WCKDai/tinyrex/design/AUDIT.md

# TinyREX v4 — model audit

A part-by-part check of the Blender model:
- what each part is and what it is made of;
- whether it can be printed, fixed and assembled;
- whether everything clears everything else in motion;
- how it compares with Microduck.

The checks are scripts, re-run after every change:

| Check | Script | What it does |
|---|---|---|
| Inventory | `blender/audit.py` | Role, material, size, watertightness, thinnest wall, fixings |
| Clips | `rig.py` `clips` / `part_check` | Every joint swept through its range against every part |
| Floating parts | `rig.py` `supports` | Each part must reach its body's hardware through parts it touches |
| Screws | `v4_parts.py` `part_bosses` | Rays along each screw: thread or insert behind it, or a boss is added |
| Limits | `limits.py` bisection | Collision-free joint ranges |
| Balance | `blender/mass.py` | Mass and balance |
| Simulation | `sim/stand_test.py` | Standing in MuJoCo |

Labelled renders: `renders/labelled-{hero,back,exploded}-annotated.png`.

## Inventory

The model has **266 parts**:
- 18 Dynamixel XL330 servos, each named by the joint it drives in the labelled renders;
- 23 frame brackets and 14 bearings, in Microduck's layout;
- 13 electronics parts and 3 cables (the camera CSI flex and the two arm-servo leads);
- 64 printed parts in PETG: 9 shells and the rest solid-modelled. The spikes, brows, eye sockets, toe caps and every
  insert boss print with the part they sit on, so none is glued on any more;
- 11 TPU parts: soles, toe soles, the tail tip, and the friction parts of the four slip clutches;
- 6 steel pins (jaw shafts, cheek pins, elbow pins), 3 wave springs, the 4 mm carbon tail spine;
- 3 polycarbonate parts: the two eye domes and the visor window;
- 107 M2 screws:
  - 73 on the shells and plates;
  - 34 fixing the frame brackets into the XL330s' own case-screw holes.

The XL330s' own horn and case screws aren't counted; they come with the servos.

## Built to tumble

TinyREX falls over and gets itself up with its head, tail and arms, so it has to take knocks. Falls in the simulator
(60 walking falls, shoved hard) show the hits: the head and tail land first and fastest (about 1.7–1.8 m/s), the arms
take up to 80 N when it lands on them, the jaw hits in many falls.

- **Slip clutches** on both shoulders, the jaw and the tail. Each holds about 1.2 N·m, above anything its servo pushes
  with in a get-up (arms 0.65, tail 0.56, jaw 0.23 N·m) and below a hard fall (1.7–3 N·m), so a fall turns the part
  on its horn instead of stripping the XL330's gears. The tail stays on: it pushes the robot up.
- **A stiff tail:** rigid collars and a 4 mm carbon spine replace the TPU flex rings, so a push isn't lost to bending.
  A fall on the tail (47 N at 130 mm, 6 N·m) stresses the spine to about 950 MPa, inside a pultruded rod's strength.
- **2.4 mm shell walls** (from 2.0) in PETG; polycarbonate eye domes and visor.
- **No glue joints:** every glued detail now prints with its part.

Mass went from 1002 g to 1028 g (`MASS.md`).

## Found and fixed in this audit

| Finding | Fix |
|---|---|
| The body and the head were **single closed shells around their hardware**, so they could not be assembled | The body prints as **left and right halves**, as Microduck's shells do. Each half screws to the trunk plate on its own bosses, and the backpack and battery door bridge them. The lime head shell splits along its shoulder crease into a **head base**, screwed to the head frame through standoffs, and a **head top**, screwed down onto tabs. Microduck's head splits top and bottom the same way |
| The **battery door was buried inside the body**: it stayed at 56.8 mm when the pod floor moved down to 54 mm | A real opening in the floor, sized for the battery to come out, with the door as a cover plate under it. Two screws into standoffs on the battery holders at the front; the rear edge hooks under the floor's lip |
| **No fixing** for the head shell, the muzzle panel, the foot plates and ankle guards, or the hands | Head base: screws and standoffs to the head frame. Head top: screws onto tabs. Muzzle: screws. Foot plate: screws up into the ankle cradle, before the sole is bonded on. Ankle guards: screws into the cradle's sides. Hands: screws into the forearms |
| The elbow pin was a 0.8 mm cap, not a pin | A steel pin through both arm parts |
| **Two shin brackets per leg**: Microduck's MJCF places the shin bracket twice, as a visual and as a collision-only geom, and the builder copied both | The builder and the rig skip collision-only geoms, and the duplicates are deleted |
| The camera **visor's walls ended in slivers** (0.06–0.6 mm) at its floor cut | A full-width floor cut. The visor's walls now start clean |
| TailArm and the left eye socket and brow were **inside out** (inverted normals) | Every generated mesh is oriented outward when it is made |
| Screw bosses could land on the wrong thing: a camera lens, a 1 mm gap between two servos, an eye socket | The boss check uses a ring of rays at the boss's radius. Standoffs only land on frame brackets and servo cases. The affected screws moved |

## Checks, after the fixes

- **Clips:**
  - none at rest;
  - none within the collision-free joint limits (`blender/joint_limits.json`);
  - none in either standing pose, Microduck's HOME or TinyREX's.
- **Floating parts:** none. Every part reaches its body's hardware through parts it touches.
- **Fixings:** every printed part is either screwed down or printed or bonded with its host. Bonded parts are the spikes, the eye sockets and brows, the toe caps and soles, the visor window and the tail tip.
- **Screws:** every screw bites something:
  - a servo horn (arms);
  - an XL330 case screw hole (nape, throat, tail root);
  - a solid printed part (tail, thighs);
  - a printed boss or standoff for an M2 heat-set insert (22 bosses and standoffs).
- **Walls (3+ perimeters of a 0.4 mm nozzle):**
  - every printed part is at least 1.2 mm;
  - shells are 2.4 mm, thinner only where the wall wraps a fillet;
  - plates are 3–9 mm;
  - TPU is 3.4–8 mm;
  - the eye domes are 1.2 mm polycarbonate.
- **Watertight meshes:** the six boolean-cut shells (the body halves, both head shells, the head back cap and the visor) are **not watertight as meshes**. Their cut edges leave open seams. Slicers repair this, and the exact STEP export rebuilds them from their construction, so it is unaffected.

## Does it look as polished as Microduck?

Closer. Two things separated it; the first is done.

1. **The frame (done).** The 23 frame brackets were plain boxes the size of Microduck's. They are now TinyREX's own
   (`part_frame` in `v4_parts.py`), carved from those clip-checked envelopes, so they can't add a clip:
   - each is pocketed round everything it holds, with 0.3 mm clearance: servo cases and sockets, horns and hubs,
     bearings, the battery, the arm-servo cables. That leaves a cradle that hugs the servos;
   - plates are lightened with holes where nothing mounts behind them;
   - the battery holder is two clamps, left and right;
   - edges keep the placeholders' corner rounds;
   - they print in the boards' dark frame colour, so the robot reads as a black mechanical frame under lime and
     cream armour, as on the boards.

   - each bracket is screwed to the servos it holds through the XL330s' own threaded case holes. From each case hole,
     a ray outward finds the bracket wall, and an M2 clearance hole goes through it with a screw head outside. A
     screw that would touch anything (a bearing, a pocket, a neighbour) is removed with its hole. 34 screws remain.

   After the change: joint limits unchanged, no clips, nothing floating, all bosses resolved. In the STEP, 22 of the 23
   brackets are exact. The left battery holder is faceted: PolyCore's exact boolean returned an implausible volume for
   its battery pocket.
2. **The surfaces are panelled, not sculpted.** TinyREX's shells are ruled lofts with fillets, which reads as a toy
   robot. That is the boards' language, and the boards ask for it. Microduck's shells are smooth freeform surfaces.
   The head dome, thigh shields and tail could take a smoother loft without losing the boards' hard-surface look.

## Open items

- Ribs on the longest bracket links.
- Watertight cut shells for printing straight from the Blender meshes.
- A PolyCore report for the failures the STEP export hit; see `tools/polycore-blender/README.md`.
