WCKDai/tinyrex/design/MASS.md

# TinyREX v4 — mass and balance

Computed by `blender/mass.py` from the Blender scene; this file by `blender/write_mass_md.py`.

Microduck's masses and centres of mass come from its MJCF (its authors' CAD). TinyREX's start from those:
- subtract the Microduck parts it replaces (shells, face, eyes, jaw, feet, soles, camera parts it moves): 199.5 g;
- add its own parts: 490.3 g.

Each added part's mass is its mesh volume × material density, placed at its centroid:
- PETG 1.27 g/cm³; parts modelled solid are counted at 45 % (walls + 20 % gyroid);
- TPU 1.21; steel 7.85; NdFeB 7.5; acrylic 1.19;
- XL330 18 g; M2 screw 0.35 g.

**Check:** the same calculation puts Microduck's own centre of mass 0.5 mm from its
ankle axis in its HOME pose. Its authors tuned HOME to put it there.

## Mass

| | Microduck | TinyREX |
|---|---|---|
| Mass | 737.2 g | 1028.1 g (+39 %) |
| Centre of mass, zero pose (x, y, z mm) | [1.7, -0.0, 133.2] | [-8.5, 0.0, 133.6] |

## Standing

Microduck stands in HOME (`mjlab_microduck/robot/microduck_constants.py`):
- hip pitch / ankle ±26.2°;
- hip roll ±5°;
- neck and head pitch 20°.

TinyREX's tail moves its centre of mass back. In Microduck's HOME, TinyREX's centre of mass sits
9.6 mm behind the ankle axis, with only 11.6 mm to the heel.

**TinyREX HOME** is Microduck's HOME with these changes. It is clip-free and stored in `blender/joint_limits.json`.
- hip pitch / ankle at **18.92°**, feet flat;
- neck pitch at **16.6°**, inside its 18° collision-free limit.

| | Microduck HOME | TinyREX in Microduck HOME | TinyREX HOME |
|---|---|---|---|
| CoM ahead of ankle axis | 0.5 mm | -9.6 mm | 0.0 mm |
| CoM to heel / toe edge | — | 11.6 / 53.4 mm | 21.3 / 43.7 mm |
| CoM height | 128.7 mm | 129.8 mm | 130.3 mm |

## Static torque, standing on one leg (N·m)

Each figure is the moment of everything above each joint of the stance leg, about that joint's axis.

| Joint | Microduck zero pose | TinyREX zero pose | Microduck HOME | TinyREX in Microduck HOME | TinyREX HOME | TinyREX worst / XL330 stall (0.52) |
|---|---|---|---|---|---|---|
| hip roll | 0.161 | 0.223 | 0.157 | 0.218 | 0.218 | 43 % |
| hip pitch | 0.011 | 0.096 | 0.015 | 0.126 | 0.117 | 24 % |
| knee | 0.241 | 0.232 | 0.126 | 0.076 | 0.125 | 45 % |
| ankle | 0.241 | 0.232 | 0.002 | 0.099 | 0.003 | 45 % |

In TinyREX HOME the knees carry about what Microduck's do in its HOME, and the ankles the same. Hip
roll carries the extra mass, at about 40 % of stall. The simulation (`sim/`, see `sim/README.md`)
takes this further: it shows that both robots stand and how hard a push each survives.

## Heaviest added parts

| Part | g |
|---|---|
| BodyR | 38.0 |
| BodyL | 37.8 |
| HeadTop | 33.8 |
| HeadBack | 31.3 |
| HeadBase | 21.8 |
| TailSeg0 | 18.1 |
| XL330_TailYaw | 18.0 |
| XL330_ArmL | 18.0 |
| XL330_ArmR | 18.0 |
| Jaw | 16.2 |
| Thigh_R | 14.6 |
| Thigh_L | 14.6 |
