WCKDai/tinyrex/design/blender/checkpoints/v4-hard-surface-1/v4-hard-surface-hero.png

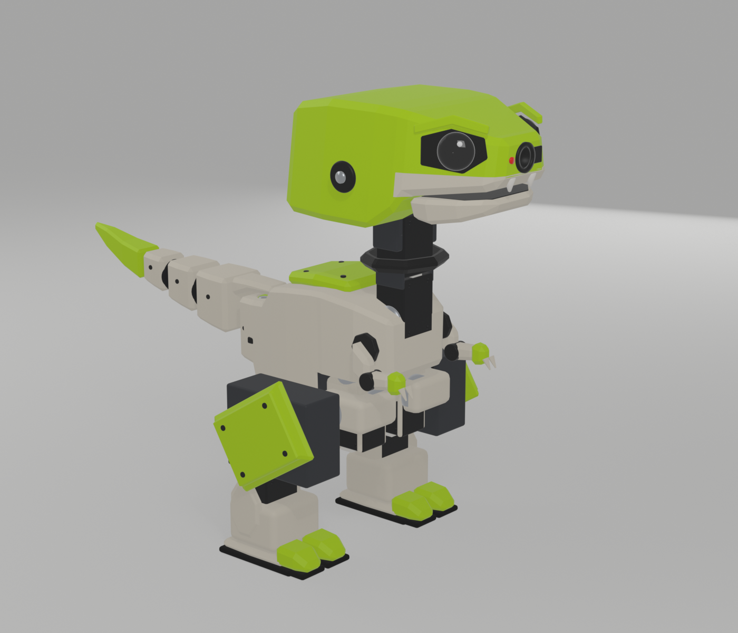
design/blender/checkpoints/v4-hard-surface-1/v4-hard-surface-hero.png
