WCKDai/tinyrex/design/blender/checkpoints/v4-hard-surface-1/v4-hard-surface-side.png

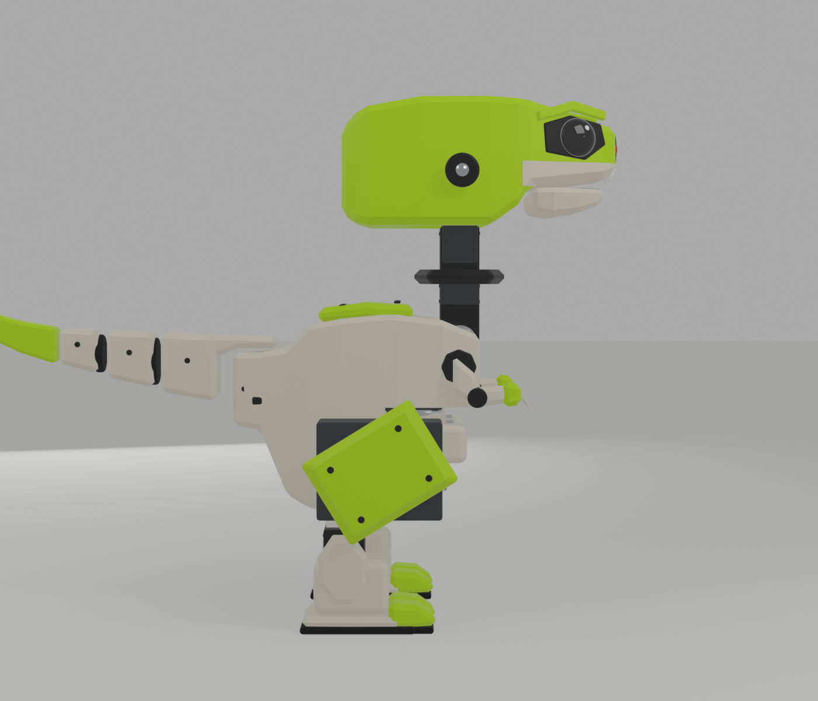
design/blender/checkpoints/v4-hard-surface-1/v4-hard-surface-side.png
