WCKDai/tinyrex/design/blender/checkpoints/v4-hard-surface-2/v4-hs2-side.png

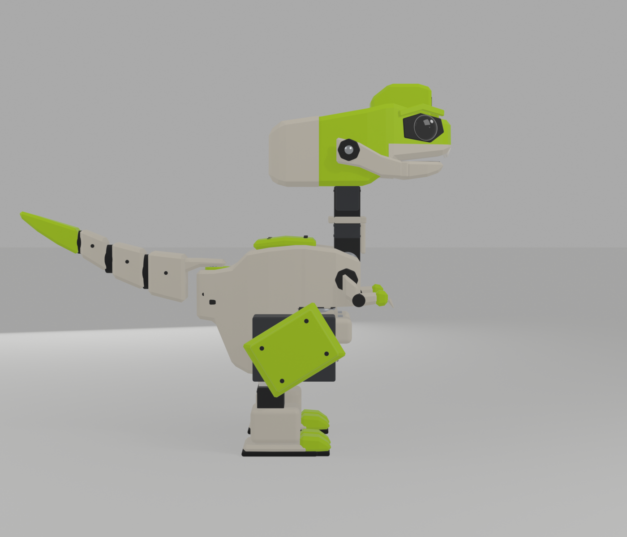
design/blender/checkpoints/v4-hard-surface-2/v4-hs2-side.png
