WCKDai/tinyrex/design/blender/out/tinyrex-front.png

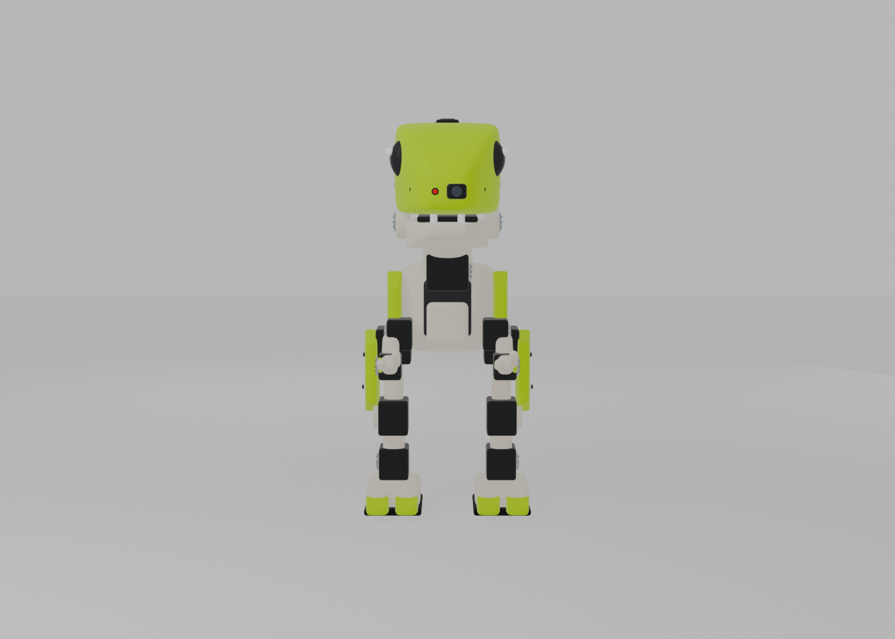
design/blender/out/tinyrex-front.png
