WCKDai/tinyrex/design/blender/out/tinyrex-hero.png

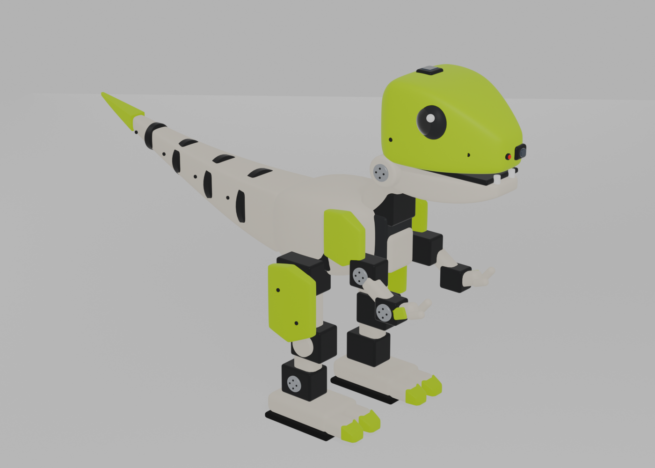
design/blender/out/tinyrex-hero.png
