WCKDai/tinyrex/design/blender/out/tinyrex-side.png

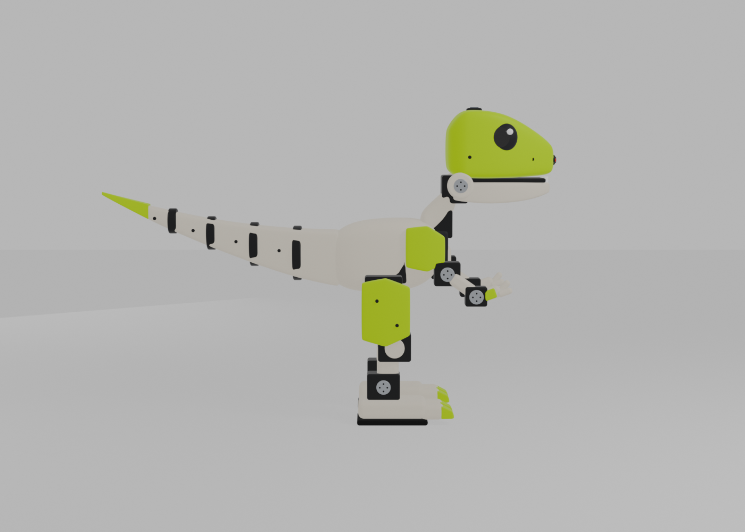
design/blender/out/tinyrex-side.png
