WCKDai/tinyrex/design/blender/out/tinyrex-top.png

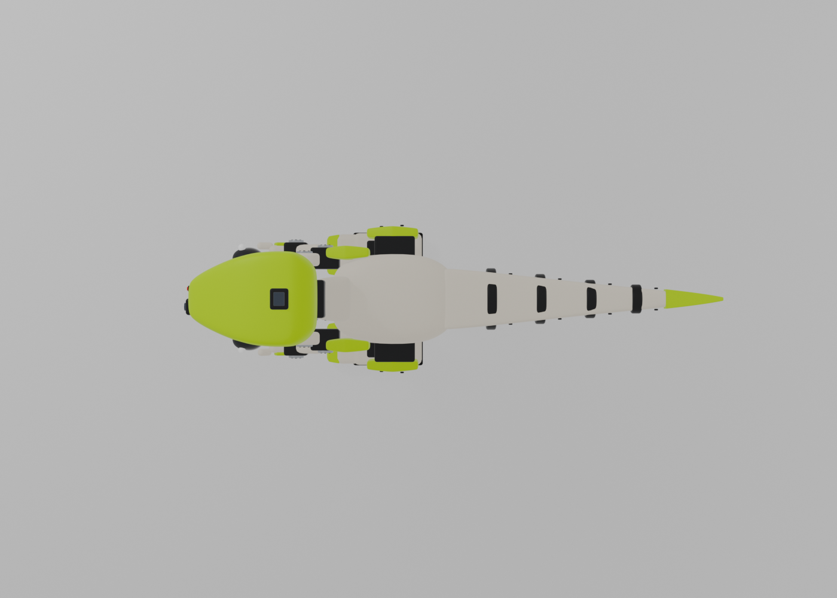
design/blender/out/tinyrex-top.png
