WCKDai/tinyrex/design/polykrom/polykrom-front.png

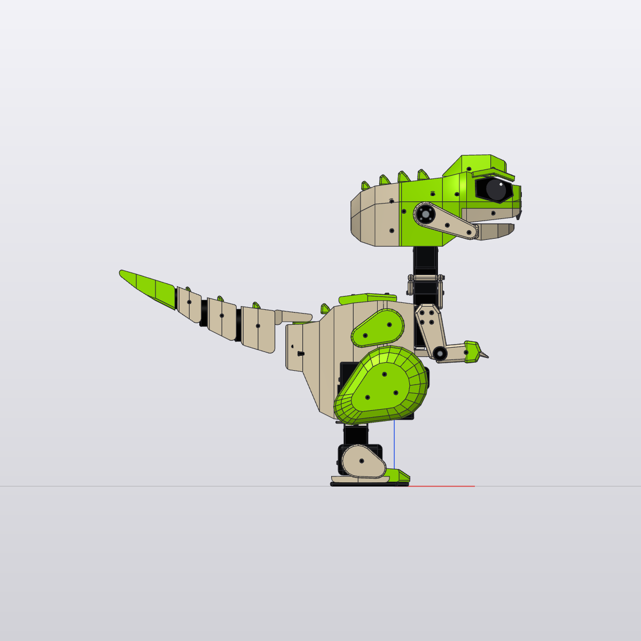
design/polykrom/polykrom-front.png
