WCKDai/tinyrex/design/polykrom/polykrom-iso.png

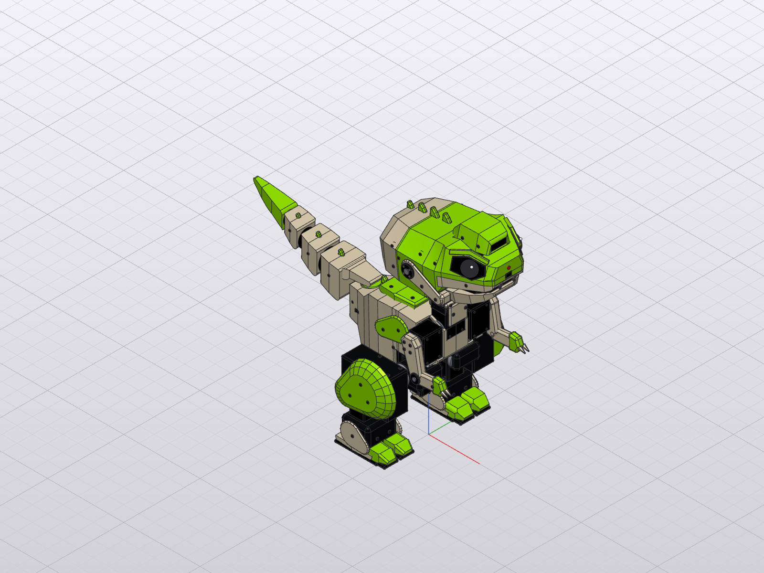
design/polykrom/polykrom-iso.png
