WCKDai/tinyrex/design/renders/head-v1-front.png

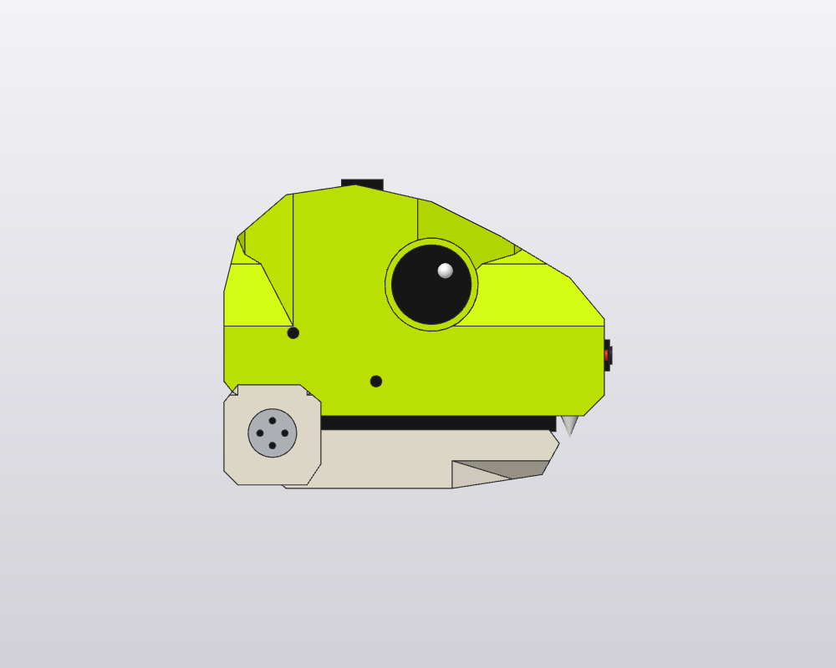
design/renders/head-v1-front.png
