WCKDai/tinyrex/design/renders/head-v1-iso.png

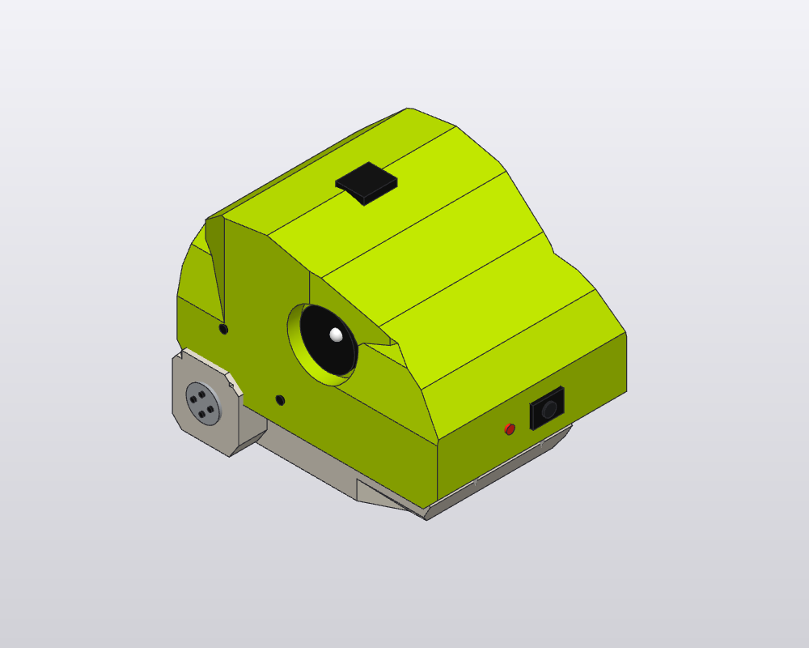
design/renders/head-v1-iso.png
