WCKDai/tinyrex/design/renders/head-v1-top.png

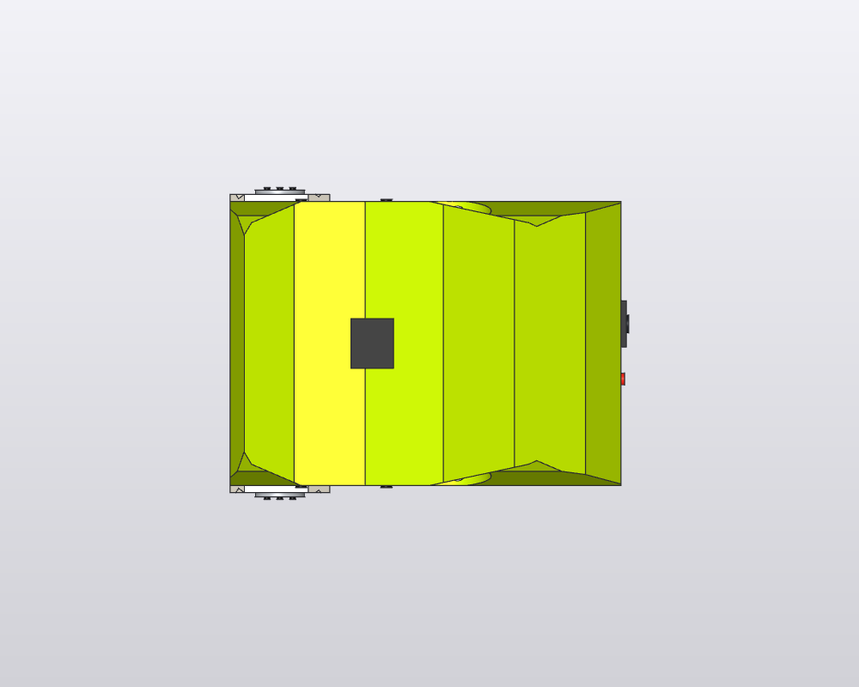
design/renders/head-v1-top.png
