WCKDai/tinyrex/design/renders/head-v2-right.png

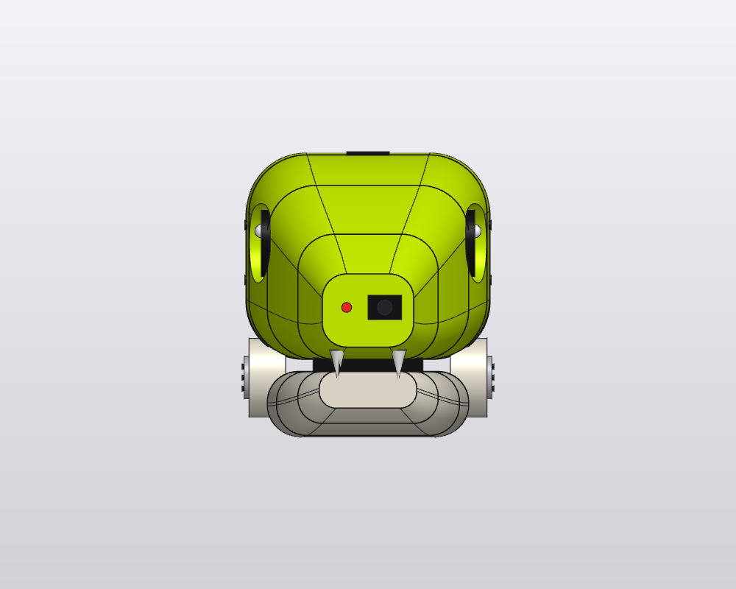
design/renders/head-v2-right.png
