WCKDai/tinyrex/design/renders/head-v2-top.png

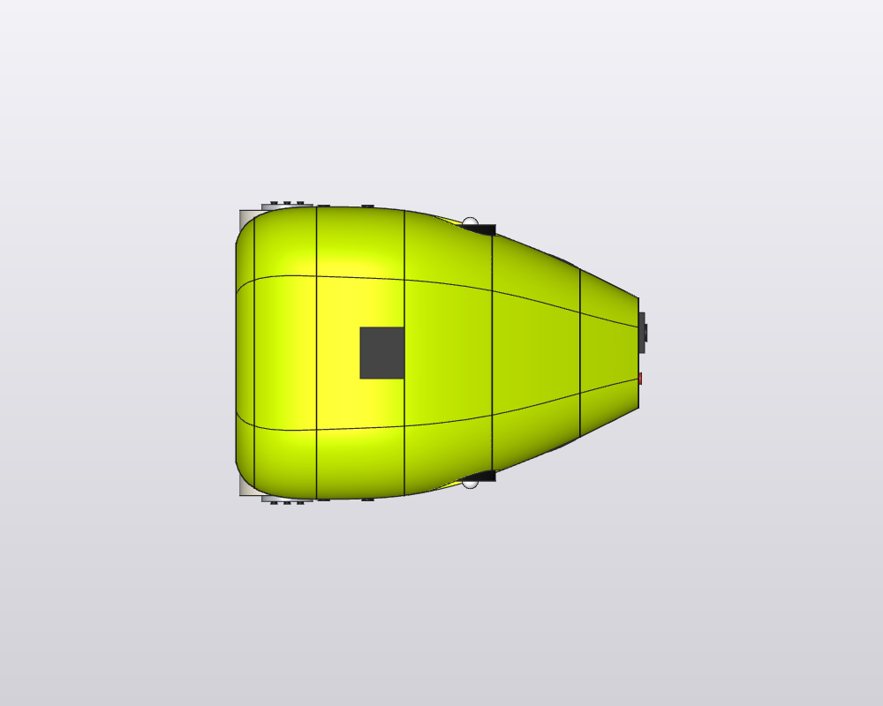
design/renders/head-v2-top.png
