WCKDai/tinyrex/design/renders/head-v3-front.png

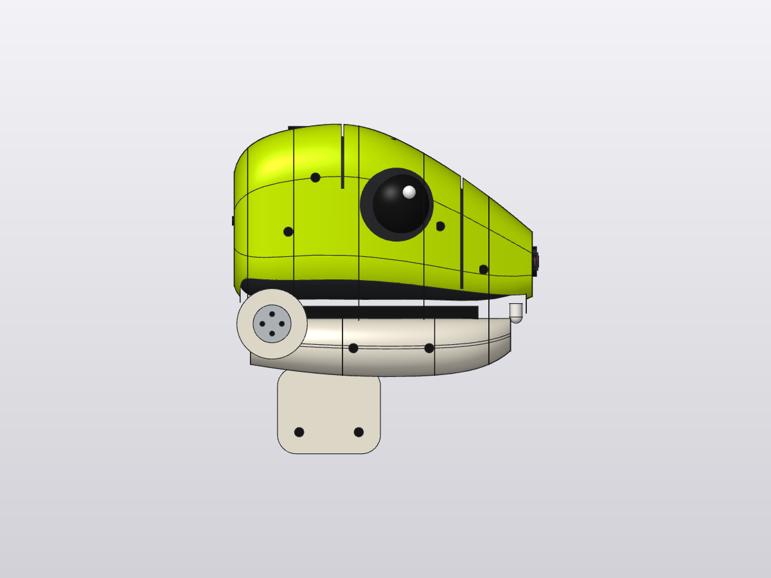
design/renders/head-v3-front.png
