WCKDai/tinyrex/design/renders/head-v3-iso.png

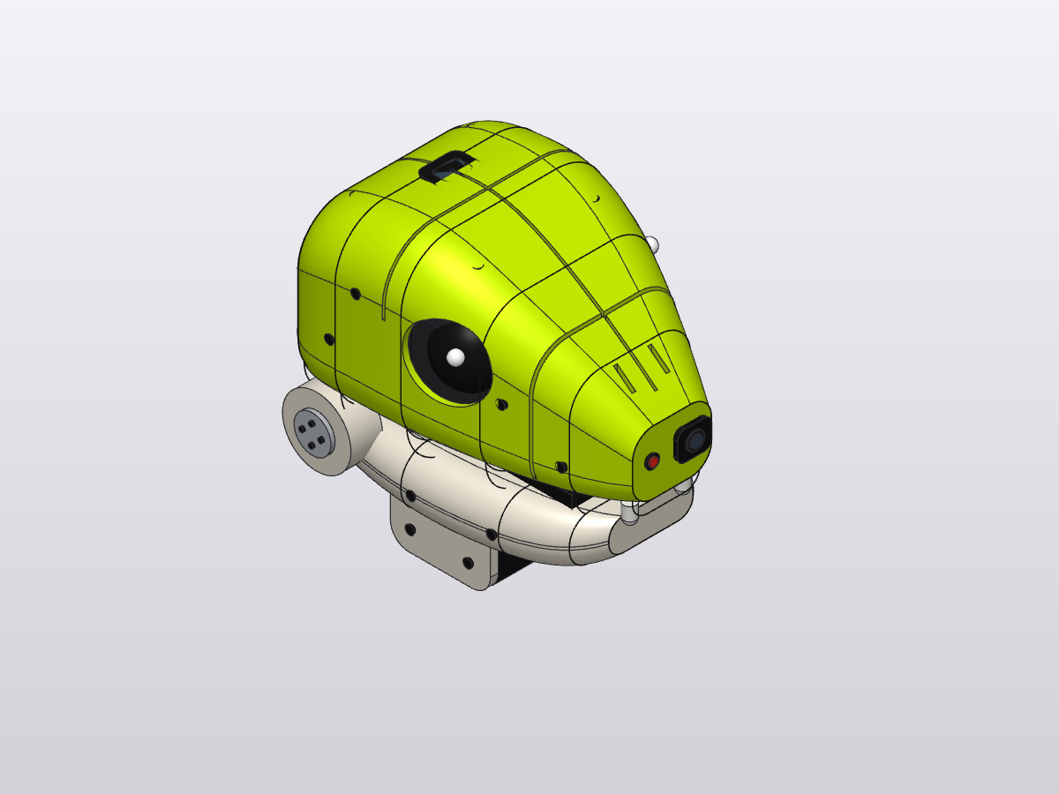
design/renders/head-v3-iso.png
