WCKDai/tinyrex/design/renders/head-v3-right.png

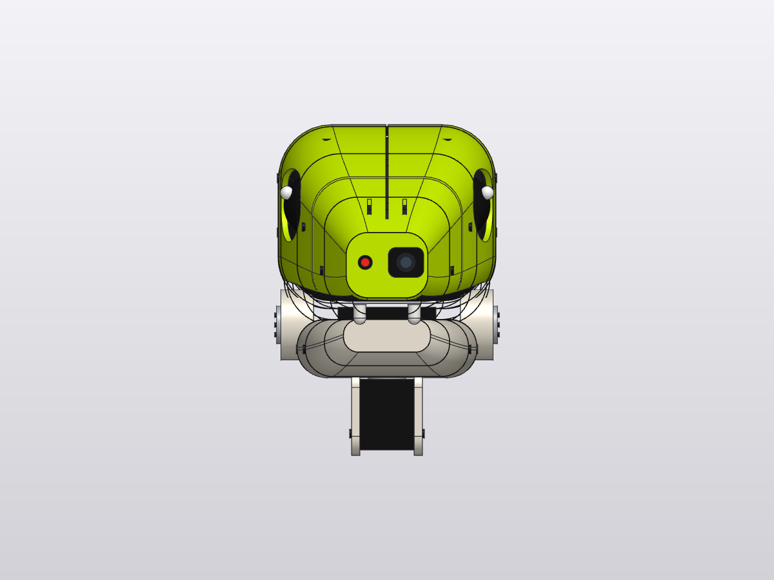
design/renders/head-v3-right.png
