WCKDai/tinyrex/design/renders/labelled-back.png

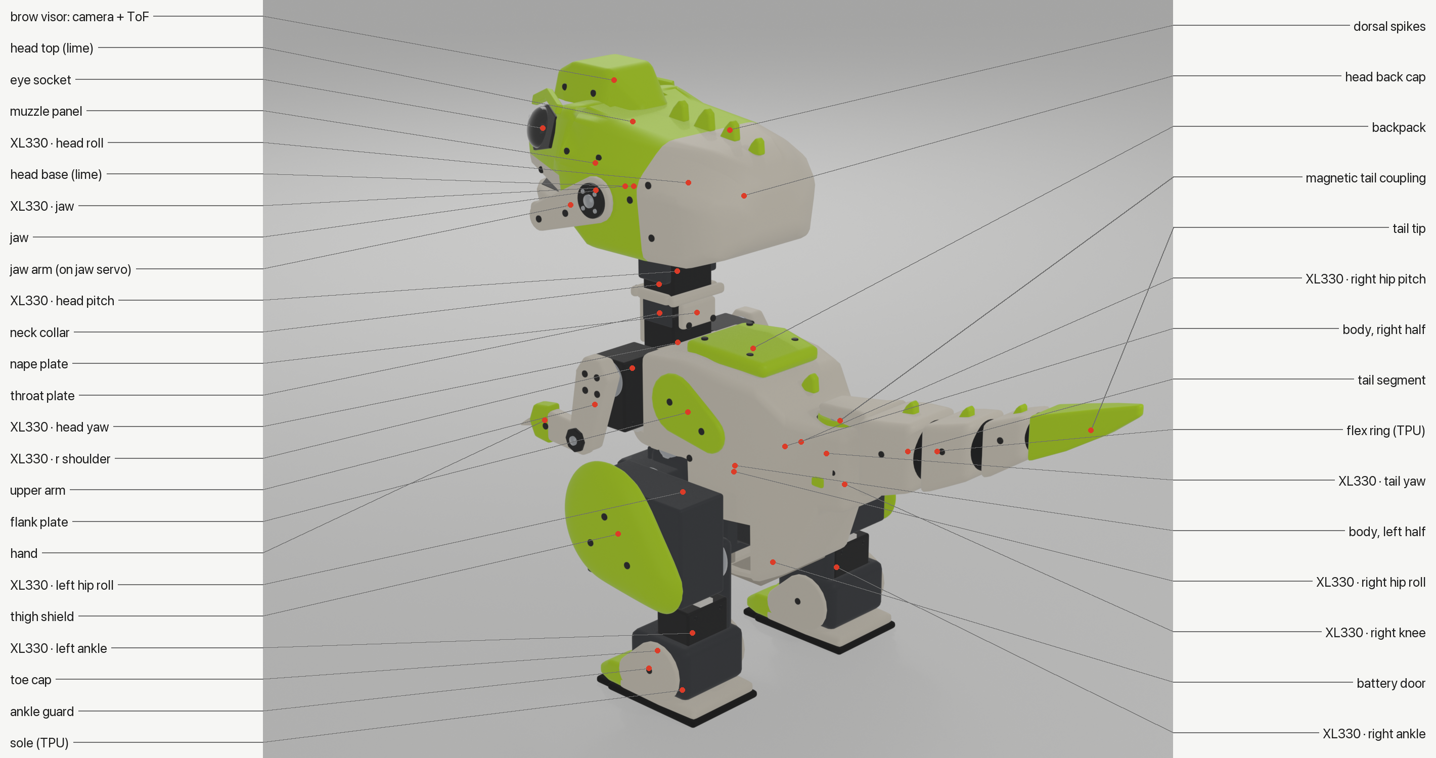
design/renders/labelled-back.png
