WCKDai/tinyrex/design/renders/labelled-exploded.png

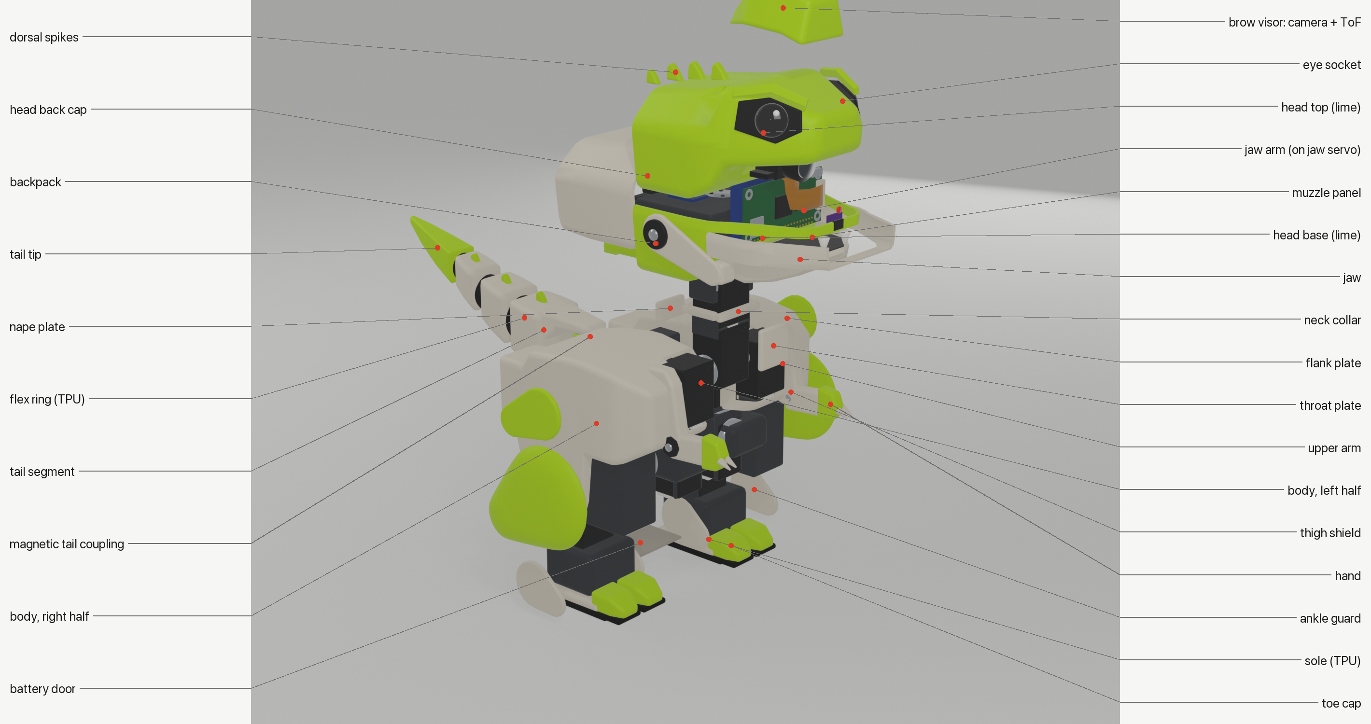
design/renders/labelled-exploded.png
