WCKDai/tinyrex/design/renders/sim-home.png

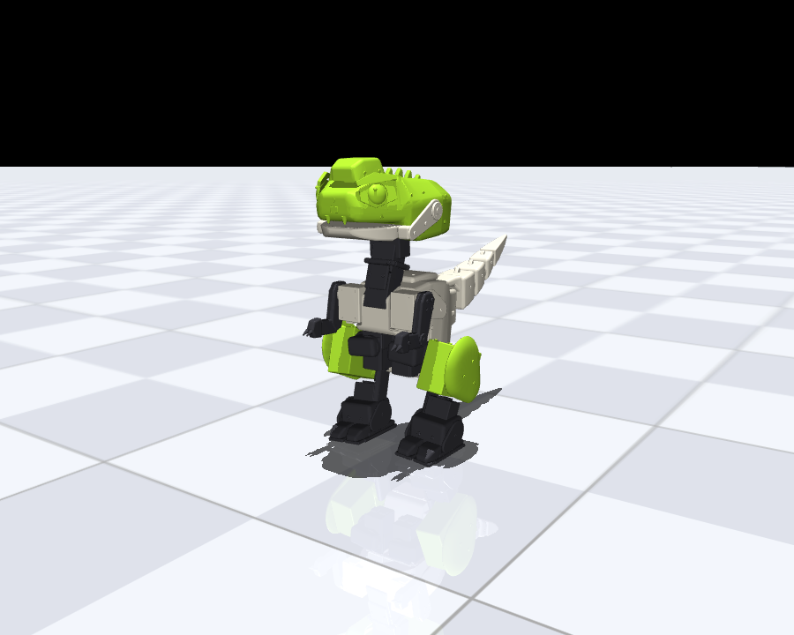
design/renders/sim-home.png
