WCKDai/tinyrex/design/renders/sim-roar.gif

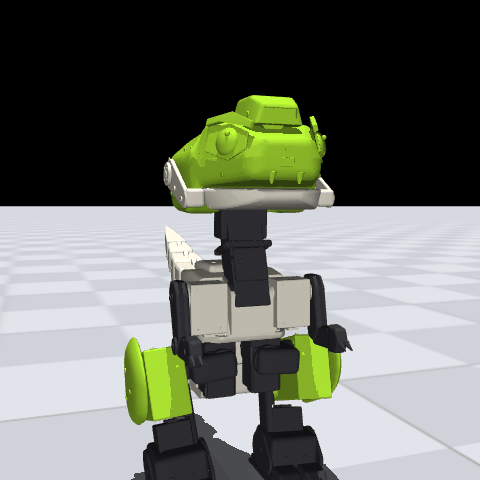
design/renders/sim-roar.gif
