WCKDai/tinyrex/design/renders/v4-face-front.png

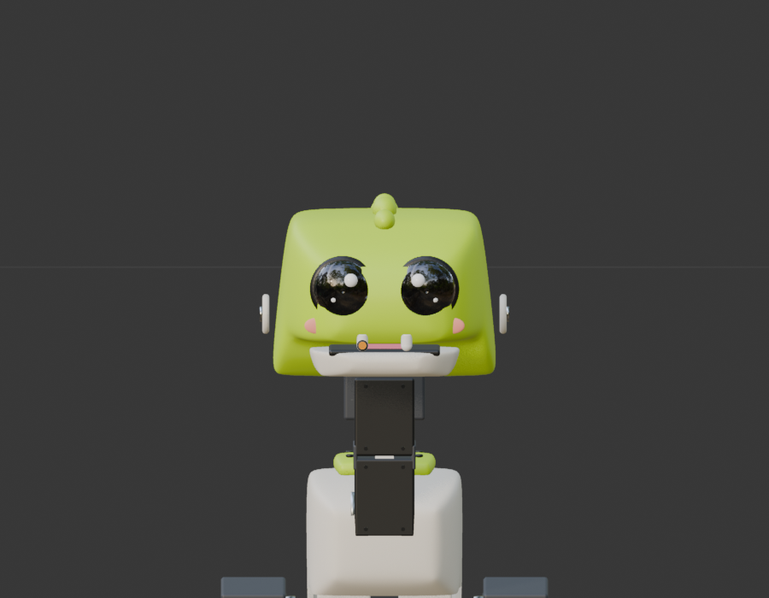
design/renders/v4-face-front.png
