WCKDai/tinyrex/design/renders/v4-face-side.png

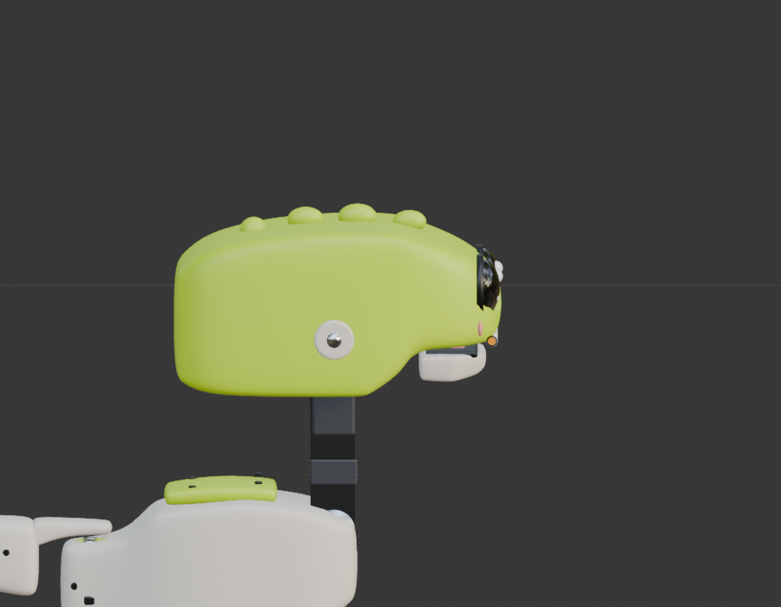
design/renders/v4-face-side.png
