WCKDai/tinyrex/design/renders/v4-face-three_q.png

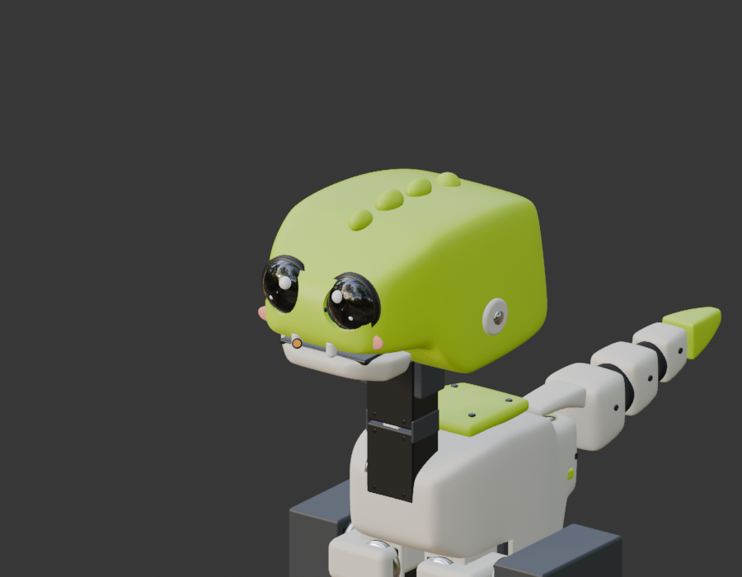
design/renders/v4-face-three_q.png
