WCKDai/tinyrex/design/renders/v4-hs3-hero.png

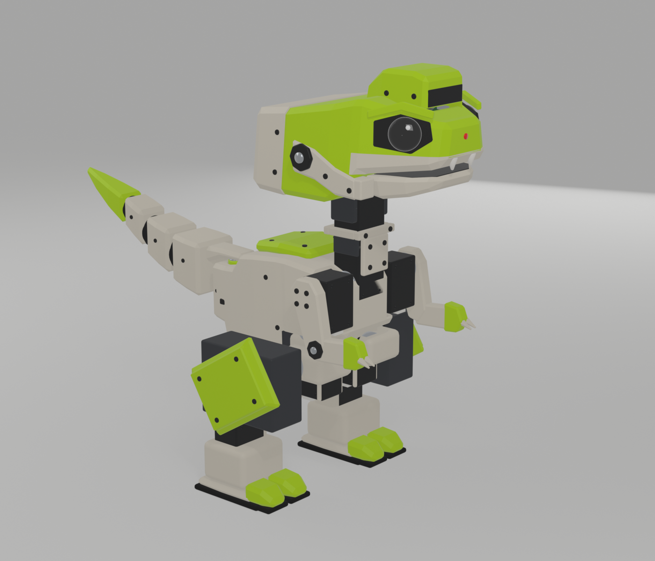
design/renders/v4-hs3-hero.png
