WCKDai/tinyrex/design/renders/v4-hs4-back.png

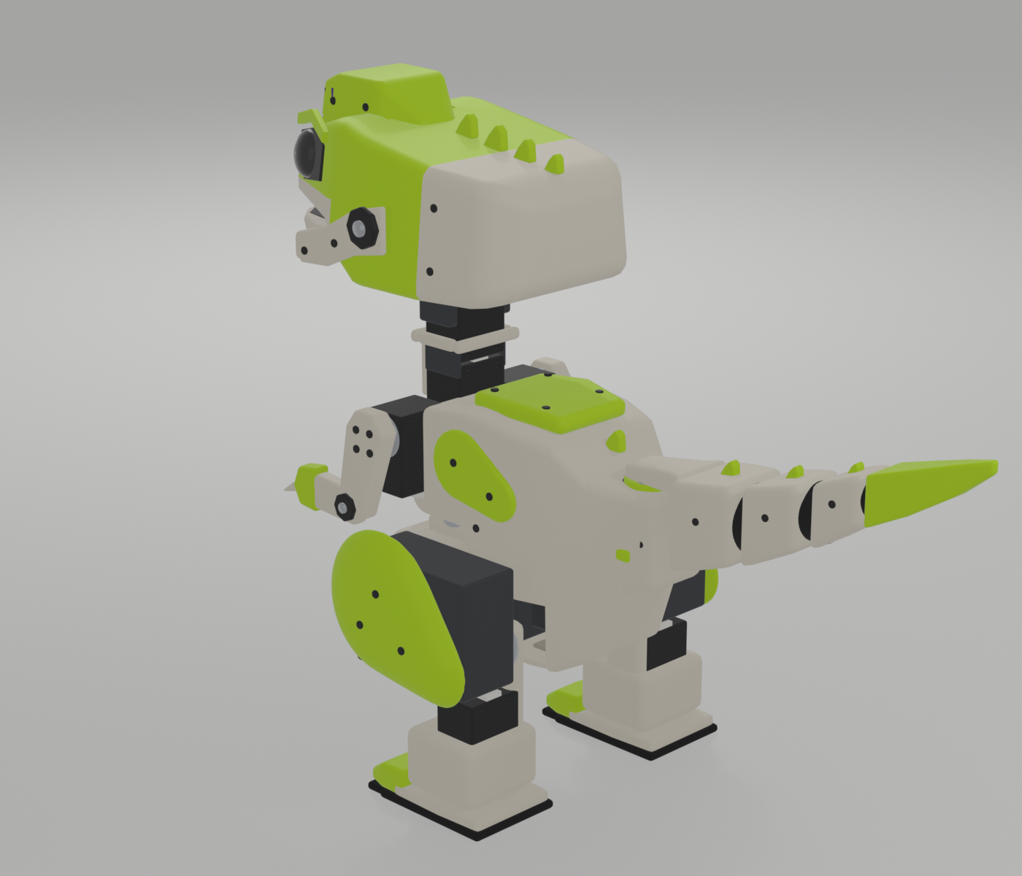
design/renders/v4-hs4-back.png
