WCKDai/tinyrex/design/renders/v4-hs5-headq.png

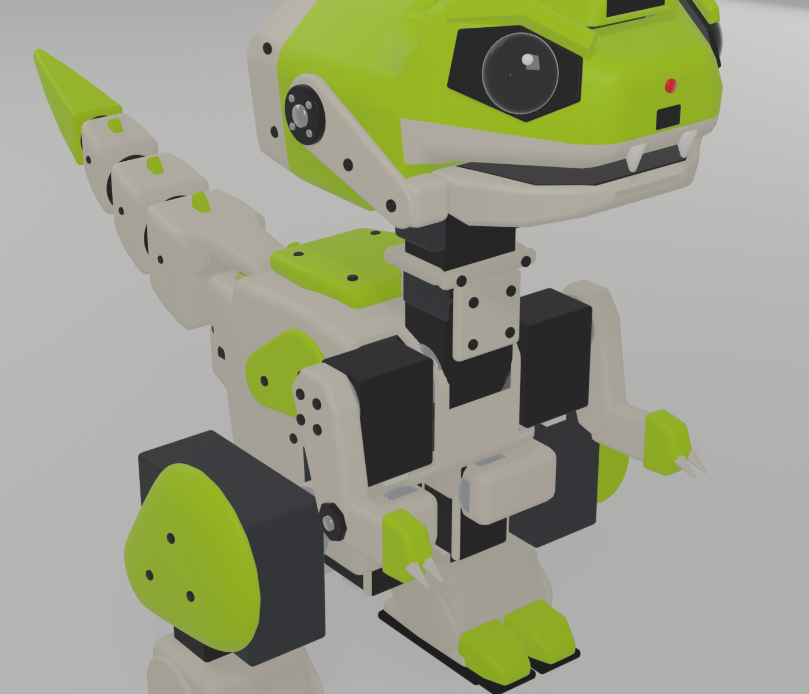
design/renders/v4-hs5-headq.png
