WCKDai/tinyrex/results/rex-bom.csv

item | part_number | description | revision | count | definition
1 | ISO 4762 M2.5x10 | Socket head cap screw M2.5x10 |  | 4 | M2.5x10 Pi1; M2.5x10 Pi2; M2.5x10 Pi3; M2.5x10 Pi4
2 | ISO 4762 M2.5x8 | Socket head cap screw M2.5x8 |  | 2 | M2.5x8 Imu1; M2.5x8 Imu2
3 | ISO 4762 M2x10 | Socket head cap screw M2x10 |  | 8 | M2x10 HipL1; M2x10 HipL2; M2x10 HipL3; M2x10 HipL4; M2x10 HipR1; M2x10 HipR2; M2x10 HipR3; M2x10 HipR4
4 | ISO 4762 M2x6 | Socket head cap screw M2x6 |  | 24 | M2x6 RollL1; M2x6 RollL2; M2x6 RollL3; M2x6 RollL4; M2x6 PitchL1; M2x6 PitchL2; M2x6 PitchL3; M2x6 PitchL4; M2x6 ARollL1; M2x6 ARollL2; M2x6 ARollL3; M2x6 ARollL4; M2x6 RollR1; M2x6 RollR2; M2x6 RollR3; M2x6 RollR4; M2x6 PitchR1; M2x6 PitchR2; M2x6 PitchR3; M2x6 PitchR4; M2x6 ARollR1; M2x6 ARollR2; M2x6 ARollR3; M2x6 ARollR4
5 | ISO 4762 M2x8 | Socket head cap screw M2x8 |  | 32 | M2x8 KneeL1; M2x8 KneeL2; M2x8 KneeL3; M2x8 KneeL4; M2x8 AnkleL1; M2x8 AnkleL2; M2x8 AnkleL3; M2x8 AnkleL4; M2x8 KneeR1; M2x8 KneeR2; M2x8 KneeR3; M2x8 KneeR4; M2x8 AnkleR1; M2x8 AnkleR2; M2x8 AnkleR3; M2x8 AnkleR4; M2x8 Neck1; M2x8 Neck2; M2x8 Neck3; M2x8 Neck4; M2x8 HeadPitch1; M2x8 HeadPitch2; M2x8 HeadPitch3; M2x8 HeadPitch4; M2x8 HeadYaw1; M2x8 HeadYaw2; M2x8 HeadYaw3; M2x8 HeadYaw4; M2x8 TailYaw1; M2x8 TailYaw2; M2x8 TailYaw3; M2x8 TailYaw4
6 | ISO 4762 M3x10 | Socket head cap screw M3x10 |  | 8 | M3x10 Plate1; M3x10 Plate2; M3x10 Plate3; M3x10 Plate4; M3x10 Plate5; M3x10 Plate6; M3x10 ArmL; M3x10 ArmR
7 | ISO 4762 M3x6 | Socket head cap screw M3x6 |  | 6 | M3x6 Strap1; M3x6 Strap2; M3x6 NeckMount1; M3x6 NeckMount2; M3x6 TailMount1; M3x6 TailMount2
8 | SG90 | Servo, serial bus and hobby (case, mounting holes, horn) SG90 |  | 1 | JawServo
9 | STS3215 | Servo, serial bus and hobby (case, mounting holes, horn) STS3215 |  | 16 | HipYawServo_L; HipYawServo_R; HipRollServo_L; HipPitchServo_L; KneeServo_L; AnklePitchServo_L; AnkleRollServo_L; HipRollServo_R; HipPitchServo_R; KneeServo_R; AnklePitchServo_R; AnkleRollServo_R; NeckPitchServo; HeadPitchServo; HeadYawServo; TailYawServo
10 |  |  |  | 1 | AnklePitchServo_L horn
11 |  |  |  | 1 | AnklePitchServo_R horn
12 |  |  |  | 1 | AnkleRollBracket_L
13 |  |  |  | 1 | AnkleRollBracket_R
14 |  |  |  | 1 | AnkleRollServo_L horn
15 |  |  |  | 1 | AnkleRollServo_R horn
16 |  |  |  | 1 | ArmourPlate
17 |  |  |  | 1 | BNO085
18 |  |  |  | 1 | BatteryStrap
19 |  |  |  | 1 | BrowRidge_L
20 |  |  |  | 1 | BrowRidge_R
21 |  |  |  | 1 | Claw_L1
22 |  |  |  | 1 | Claw_L2
23 |  |  |  | 1 | Claw_L3
24 |  |  |  | 1 | Claw_R1
25 |  |  |  | 1 | Claw_R2
26 |  |  |  | 1 | Claw_R3
27 |  |  |  | 1 | Claws_L
28 |  |  |  | 1 | Claws_R
29 |  |  |  | 1 | EyeSocket_L
30 |  |  |  | 1 | EyeSocket_R
31 |  |  |  | 1 | Foot_L
32 |  |  |  | 1 | Foot_R
33 |  |  |  | 1 | HeadBracket
34 |  |  |  | 1 | HeadPitchServo horn
35 |  |  |  | 1 | HeadYawServo horn
36 |  |  |  | 1 | HipPitchBracket_L
37 |  |  |  | 1 | HipPitchBracket_R
38 |  |  |  | 1 | HipPitchServo_L horn
39 |  |  |  | 1 | HipPitchServo_R horn
40 |  |  |  | 1 | HipRollBracket_L
41 |  |  |  | 1 | HipRollBracket_R
42 |  |  |  | 1 | HipRollServo_L horn
43 |  |  |  | 1 | HipRollServo_R horn
44 |  |  |  | 1 | HipYawServo_L horn
45 |  |  |  | 1 | HipYawServo_R horn
46 |  |  |  | 1 | Jaw
47 |  |  |  | 1 | JawServo horn
48 |  |  |  | 1 | KneeServo_L horn
49 |  |  |  | 1 | KneeServo_R horn
50 |  |  |  | 1 | LiPo2S
51 |  |  |  | 1 | LowerTeeth
52 |  |  |  | 1 | Neck
53 |  |  |  | 1 | NeckMount
54 |  |  |  | 1 | NeckPitchServo horn
55 |  |  |  | 1 | PiZero2W
56 |  |  |  | 1 | PixelBadge
57 |  |  |  | 1 | Shin_L
58 |  |  |  | 1 | Shin_R
59 |  |  |  | 1 | Skull
60 |  |  |  | 1 | SolePad_L
61 |  |  |  | 1 | SolePad_R
62 |  |  |  | 1 | Tail
63 |  |  |  | 1 | TailMount
64 |  |  |  | 1 | TailSpikes
65 |  |  |  | 1 | TailYawServo horn
66 |  |  |  | 1 | Thigh_L
67 |  |  |  | 1 | Thigh_R
68 |  |  |  | 1 | TinyArm_L
69 |  |  |  | 1 | TinyArm_R
70 |  |  |  | 1 | Torso
71 |  |  |  | 1 | UpperTeeth
