WCKDai/tinyrex/design/sim/meshes/ankle_right.stl

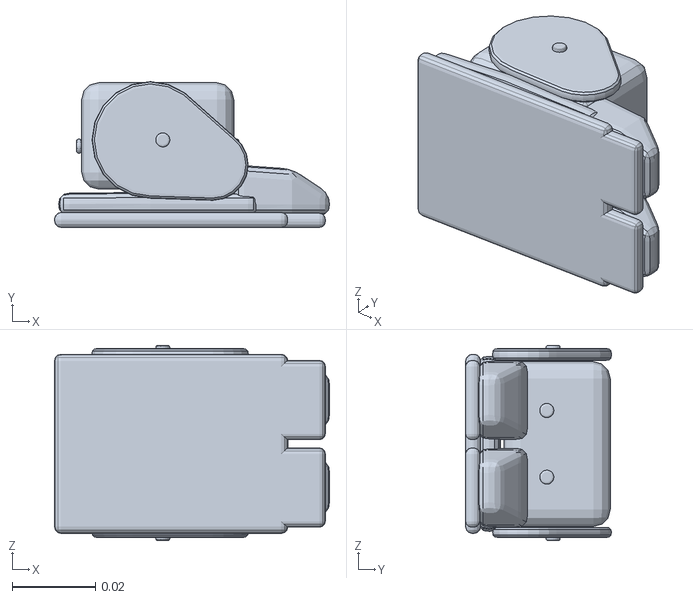
[picture p33: CAD file, 2026-10-29]
design/sim/meshes/ankle_right.stl
0.066 x 0.035 x 0.0469
