WCKDai/tinyrex/design/sim/meshes/jaw.stl

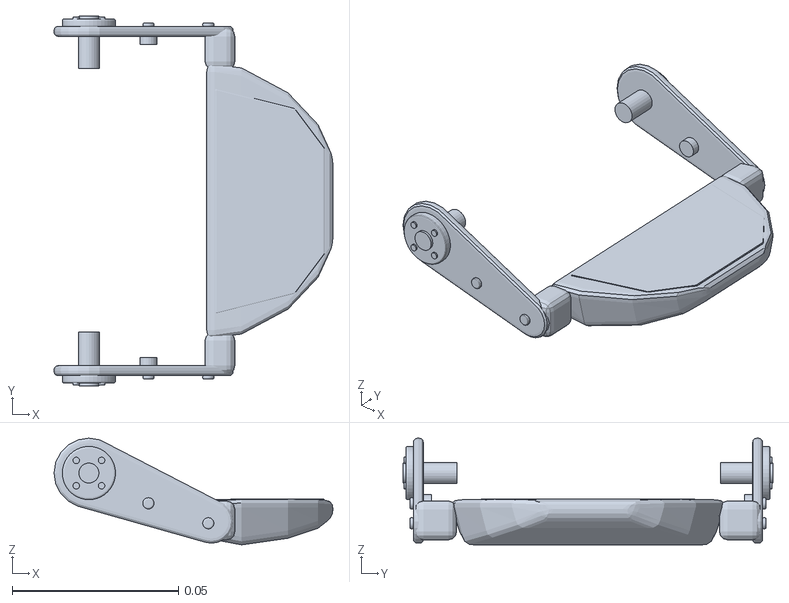
[picture p34: CAD file, 2026-10-29]
design/sim/meshes/jaw.stl
0.0839 x 0.111 x 0.0321
