WCKDai/tinyrex/design/sim/meshes/trunk_base.stl

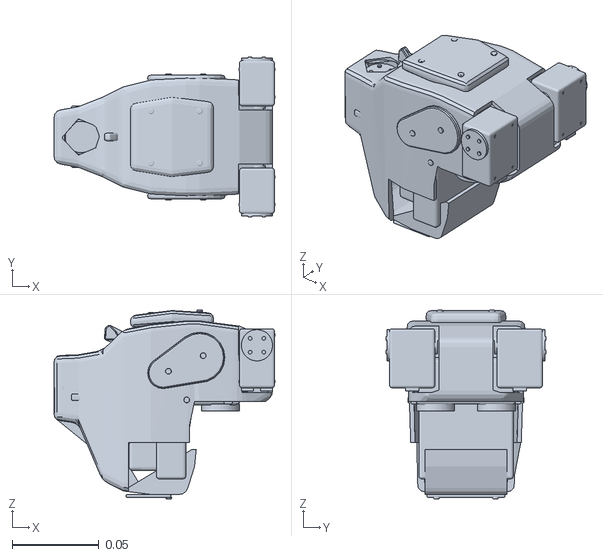
[picture p35: CAD file, 2026-10-29]
design/sim/meshes/trunk_base.stl
0.127 x 0.0922 x 0.109
