WCKDai/tinyrex/design/sim/meshes/arm_R.stl

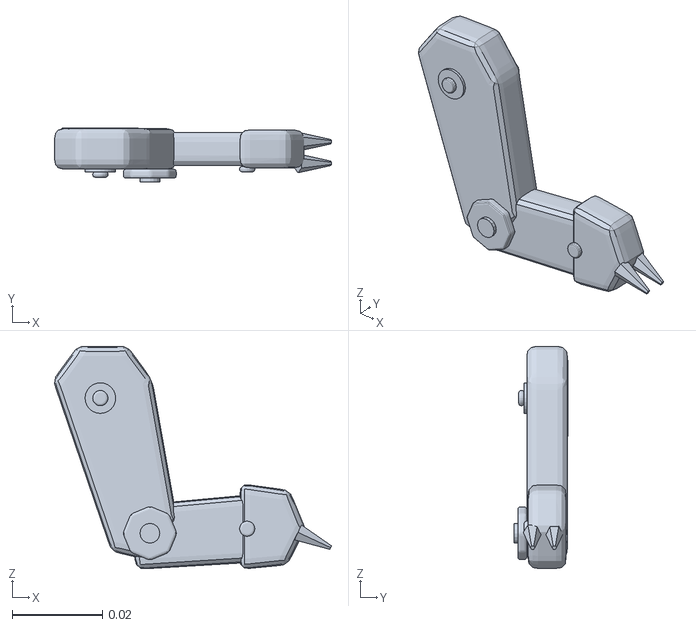
[picture p36: CAD file, 2026-10-29]
design/sim/meshes/arm_R.stl
0.0615 x 0.0119 x 0.0494
