WCKDai/tinyrex/design/sim/meshes/arm_L.stl

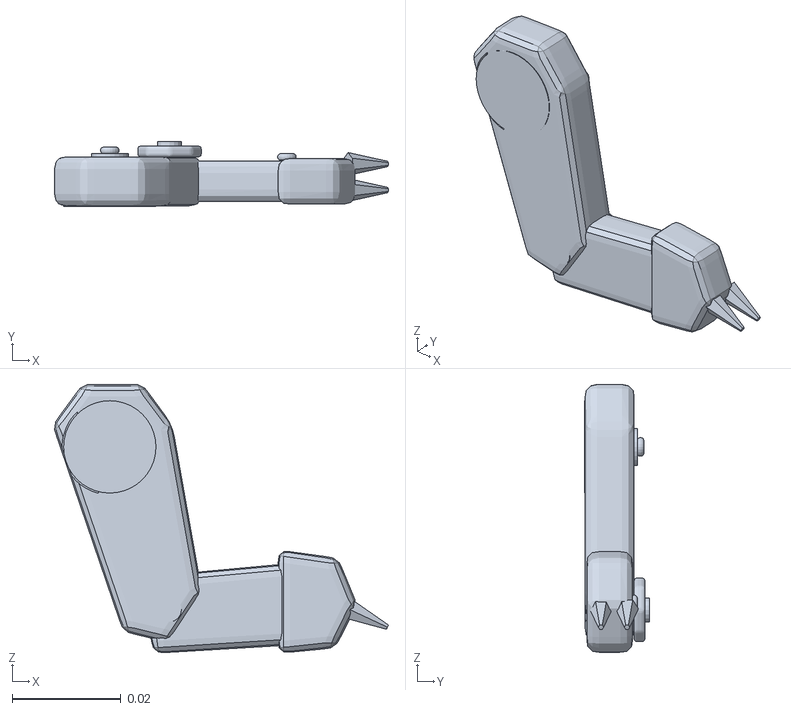
[picture p37: CAD file, 2026-10-29]
design/sim/meshes/arm_L.stl
0.0615 x 0.0119 x 0.0494
