WCKDai/tinyrex/design/sim/meshes/tail.stl

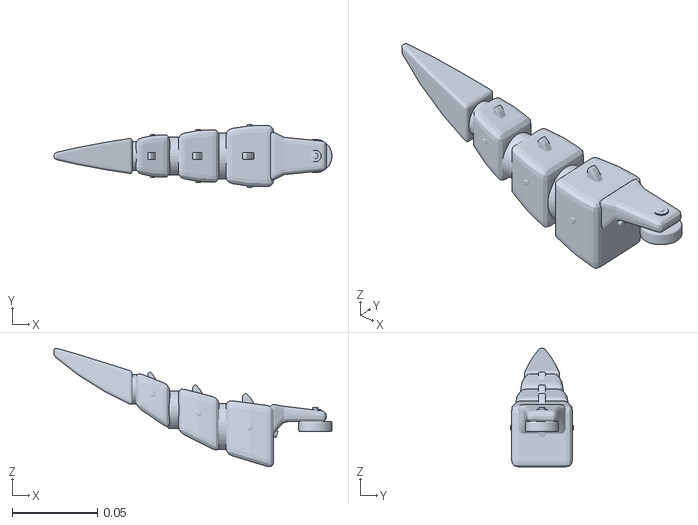
[picture p38: CAD file, 2026-10-29]
design/sim/meshes/tail.stl
0.163 x 0.0369 x 0.0696
