WCKDai/tinyrex/design/sim/meshes/jaw_soft.stl

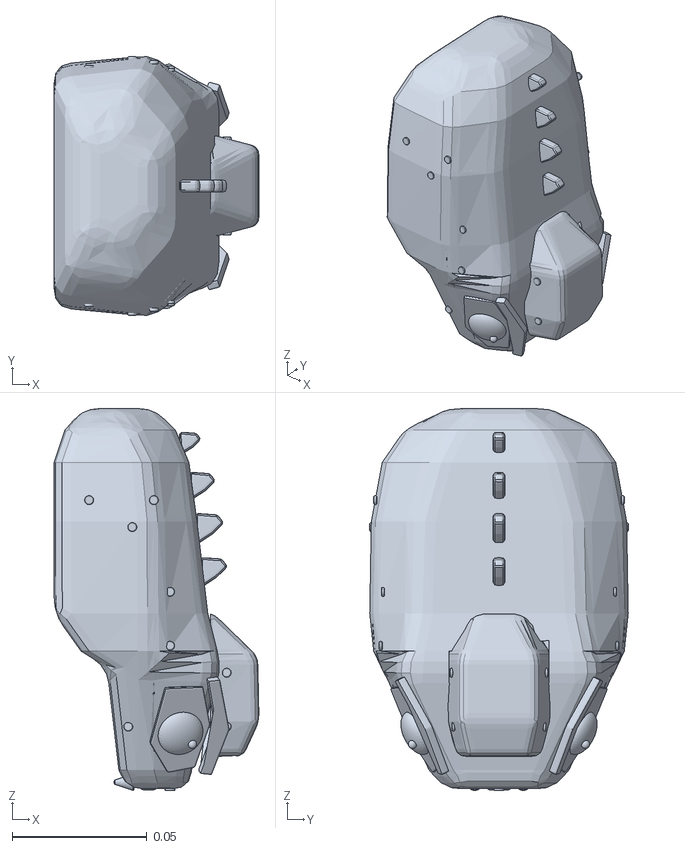
[picture p39: CAD file, 2026-10-29]
design/sim/meshes/jaw_soft.stl
0.0759 x 0.0959 x 0.142
