WCKDai/tinyrex/design/sim/meshes/upper_leg_right.stl

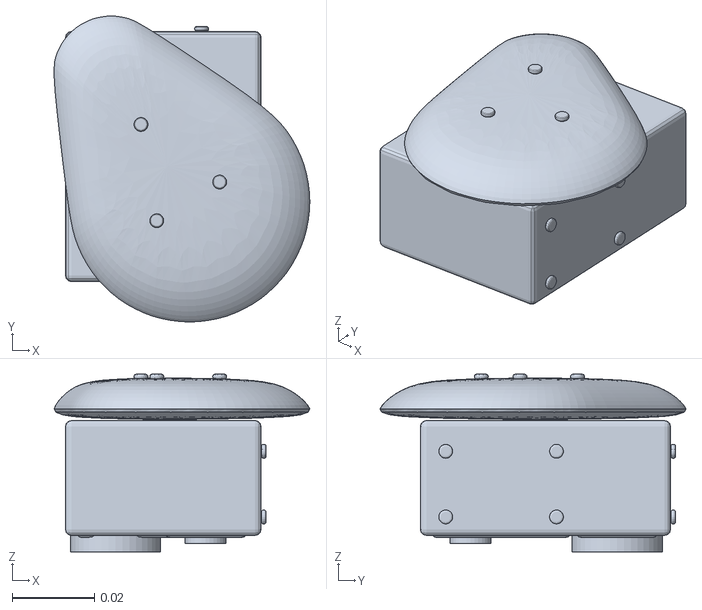
[picture p40: CAD file, 2026-10-29]
design/sim/meshes/upper_leg_right.stl
0.0623 x 0.0746 x 0.0433
