WCKDai/tinyrex/design/sim/meshes/bearing_roll.stl

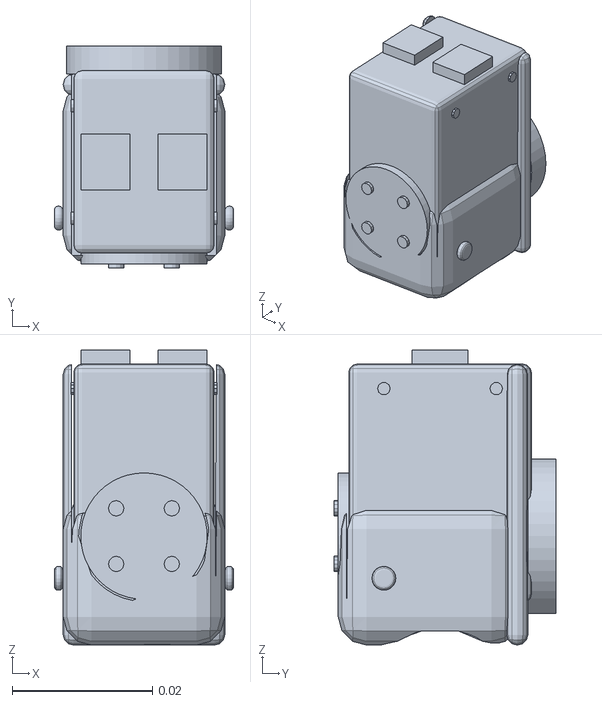
[picture p41: CAD file, 2026-10-29]
design/sim/meshes/bearing_roll.stl
0.0255 x 0.0316 x 0.042
