WCKDai/tinyrex/design/sim/meshes/yaw2roll.stl

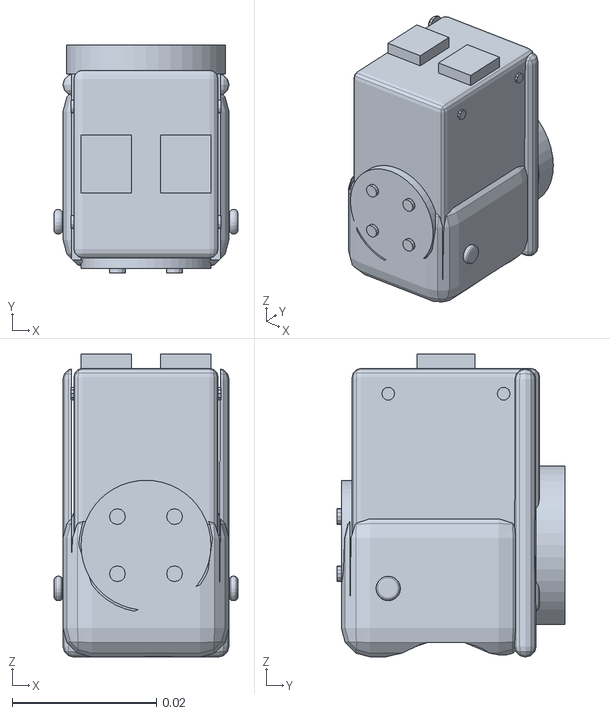
[picture p42: CAD file, 2026-10-29]
design/sim/meshes/yaw2roll.stl
0.0255 x 0.0316 x 0.042
