WCKDai/tinyrex/design/sim/meshes/yaw_roll_motion.stl

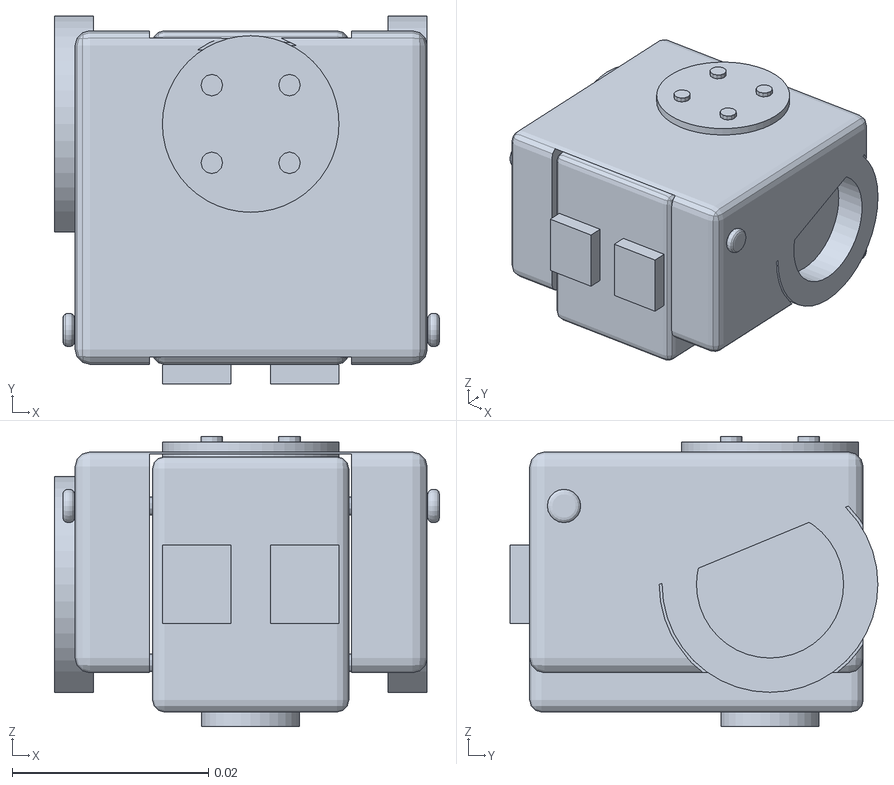
[picture p43: CAD file, 2026-10-29]
design/sim/meshes/yaw_roll_motion.stl
0.0393 x 0.0375 x 0.0296
