WCKDai/tinyrex/design/sim/meshes/hip_l.stl

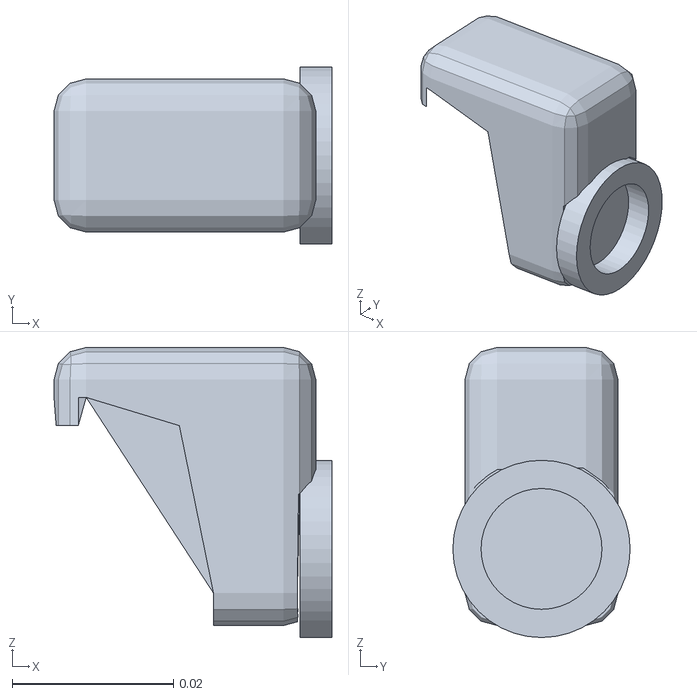
[picture p44: CAD file, 2026-10-29]
design/sim/meshes/hip_l.stl
0.0345 x 0.022 x 0.036
