WCKDai/tinyrex/design/sim/meshes/leg_2.stl

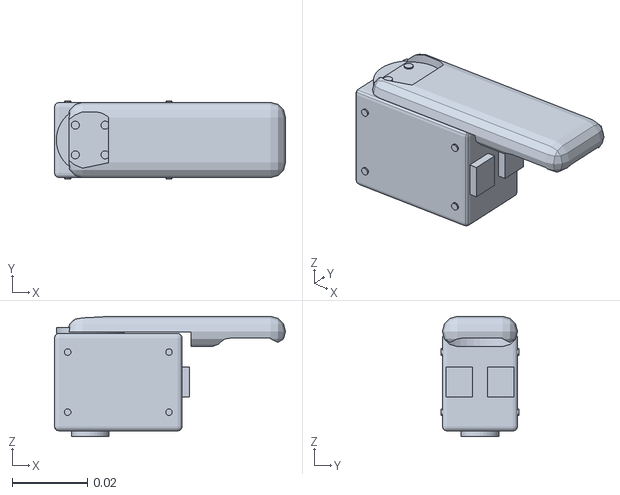
[picture p45: CAD file, 2026-10-29]
design/sim/meshes/leg_2.stl
0.0615 x 0.0208 x 0.032
