WCKDai/tinyrex/design/sim/meshes/neck_pitch.stl

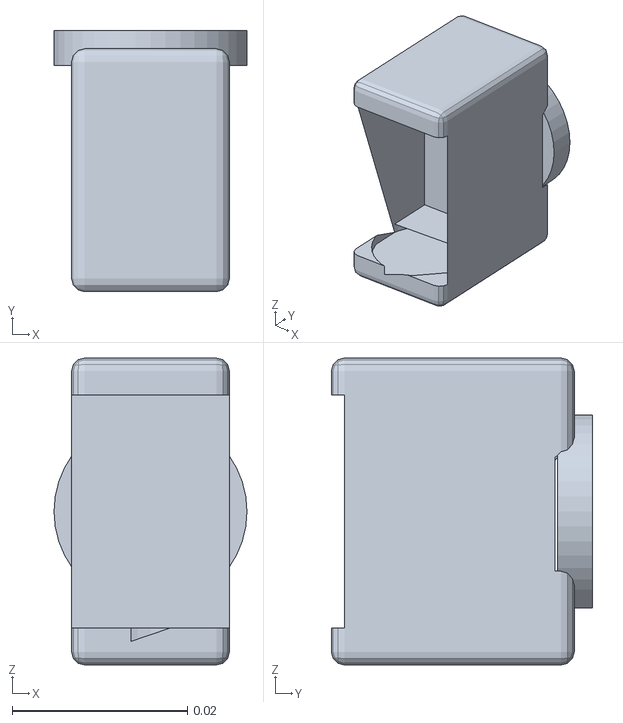
[picture p46: CAD file, 2026-10-29]
design/sim/meshes/neck_pitch.stl
0.022 x 0.0298 x 0.035
