WCKDai/tinyrex/design/sim/meshes/neck.stl

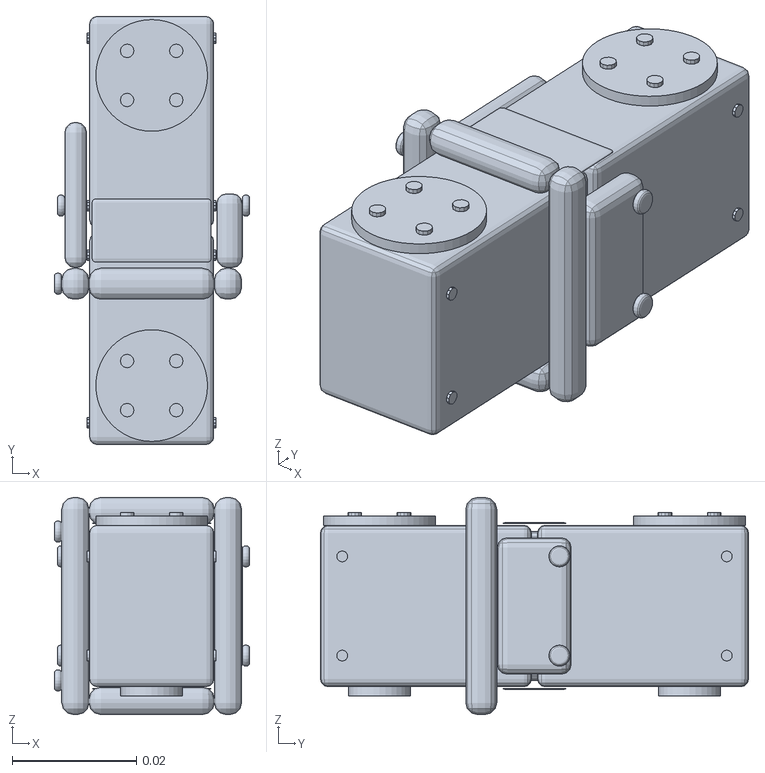
[picture p47: CAD file, 2026-10-29]
design/sim/meshes/neck.stl
0.0315 x 0.069 x 0.035
