WCKDai/tinyrex/(list of files, cad)

Other CAD files:
design/sim/meshes/ankle_left.stl
design/sim/meshes/upper_leg_left.stl
design/sim/meshes/hip_l_2.stl
design/sim/meshes/leg.stl
design/blender/checkpoints/v4-hard-surface-1/tinyrex_v4.blend
design/blender/checkpoints/v4-hard-surface-2/tinyrex_v4.blend
design/blender/checkpoints/v4-hard-surface-5/tinyrex_v4.blend
design/blender/checkpoints/v4-hard-surface-6/tinyrex_v4.blend
design/blender/out/tinyrex.blend
design/blender/tinyrex_v2.blend
design/blender/tinyrex_v3.blend
design/blender/tinyrex_v4.blend
