WCKDai/tinyrex/(commit log)

2026-10-26 feat: publish the TinyRex design, results and stage harness
    TinyRex is a small bipedal T-rex robot (17 servos, 163 parts, 1.68 kg)
    designed from an empty file by an AI agent through Polykrom's MCP
    server, in staged briefs. This adds the design after stage 7, the
    stage briefs, the harness that runs them (paths now arguments and
    environment variables), the stage reports, render, walk GIF and BOM.
    Code is Apache-2.0; the design and media are CC-BY-4.0.
    [rex-bom.csv]
2026-10-28 fix(harness): resume past a stage whose report mentions a limit
    resume.sh treated any reply containing "limit" as the usage limit, so a
    walk report about the jaw's torque limit stopped the run. It now looks
    for the usage-limit message itself.
2026-10-28 fix(harness): keep an interrupted stage's transcript when continuing it
    CONTINUE=1 reopened <stage>.transcript.jsonl for writing, so the first
    part of a stage cut short by the usage limit lost its transcript. It is
    now kept as <stage>.transcript.partN.jsonl.
2026-10-28 Design: TinyREX v4 hard-surface checkpoint (Blender scripts, scenes, renders)
    [tinyrex.blend, tinyrex_v2.blend, tinyrex_v3.blend, tinyrex_v4.blend]
2026-10-28 Design: TinyREX v4 iteration 2 - nothing floats, jaw on cheek arms, brow-visor camera
    Adds a contact-graph support check (every shell must reach its body's
    hardware), mounts for the body shell, neck collar clamp, tail coupling and
    flex rings, jaw arms on a hinge shaft through the head wall, and moves the
    camera and ToF into a raised brow visor.
    [tinyrex_v4.blend]
2026-10-28 Design: TinyREX v4 iteration 3 - arm servos, screws, leg windows, joint limits, BOM
    Each arm on its own XL330 at the shoulder (cases in body pockets), visible
    M2 screws on every mount, windows in the battery pod so the hips keep
    Microduck's range, collision-free joint limits from a full sweep, and a BOM.
    [tinyrex_v4.blend]
2026-10-28 Design: TinyREX mass and balance; panels replace overlays, 2 mm walls
    mass.py computes TinyREX's mass, centre of mass and single-leg static joint
    torques against Microduck's MJCF. Head colour panels now replace the shell
    instead of layering on it, and shells are 2 mm: 950 g (was 1007 g).
    [tinyrex_v4.blend]
2026-10-28 Design: TinyREX v4 iteration 4 - design pass: teardrop thigh shields, flank plates, dorsal spikes, brow ridge, filleted panels
    Panel edges are filleted with crisp flats; the thigh armour becomes a domed
    teardrop, lime flank plates break up the body sides, dorsal spikes run from
    crown to tail, the tail tapers continuously and the visor is a brow ridge.
    All clip, support, joint-limit and mass checks re-run.
    [tinyrex_v4.blend]
2026-10-28 Design: TinyREX v4 iteration 5 - domed skull, jaw bone, ankle guards, nape plate, slimmer visor
    The head shell gets six-point sections: wide only where the jaw servo and
    head frame are, domed above, rounded behind. Jaw arms are bone-shaped with
    servo-horn hubs; ankle guards make the feet read as shoes; a nape plate dresses
    the neck; the visor slims around a centred camera and the ToF moves to a window
    under the snout LED. Full sweep, support, limits and mass re-run.
    [tinyrex_v4.blend]
2026-10-28 Design: TinyREX v4 - standing-pose balance, cable routes, screw bosses
    mass.py now poses the rig: it reproduces Microduck's HOME balance (CoM 0.5 mm
    from the ankle axis) and finds TinyREX's own HOME (hip pitch/ankle 17.85 deg)
    that puts its CoM over the ankles. Leg windows extend so the shins clear in
    both standing poses. The camera CSI flex and both arm-servo leads are routed
    and clip-checked; a ray-based check gives every screw thread or an insert
    boss. Docs, limits and BOM updated.
    [tinyrex_v4.blend]
2026-10-28 Design: MASS.md wording - ankle torque in HOME matches Microduck's, not lower
2026-10-28 Sim: TinyREX MuJoCo model; stands, and survives bigger pushes than Microduck
    design/blender/export_sim.py integrates every part's mass and inertia per body
    and writes per-body meshes; design/sim/build_mjcf.py builds tinyrex.xml from
    Microduck's MJCF (Apache-2.0) with TinyREX's geometry, inertia, limits, the
    jaw/tail/shoulder joints and foot contacts, and scene.xml with a HOME key.
    stand_test.py compares both robots standing under stiff position hold within
    the XL330 force limit, and their push recovery. TinyREX HOME now keeps the
    neck inside its collision-free range. CREDITS.md updated: the v4 design reads
    Microduck's MJCF placements and the sim model derives from its MJCF.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
    [ankle_left.stl, ankle_right.stl, arm_L.stl, arm_R.stl, bearing_roll.stl, hip_l.stl, hip_l_2.stl, jaw.stl]
2026-10-28 Design: full model audit and fixes; PolyCore STEP exporter and Blender add-on
    Audit (design/AUDIT.md, blender/audit.py): every part inventoried and checked
    for walls, watertightness, fixings and assembly. Fixed: body and head printed
    as split shells (body L/R, head top/base) so they can be assembled; a real
    battery opening with the door as a cover plate; screws for the head, muzzle,
    feet, guards and hands; a through elbow pin; duplicate shin brackets from
    Microduck's collision geoms; visor slivers; inside-out meshes; boss placement
    via ring rays, standoffs only onto frame or servo cases. Labelled renders.
    tools/polycore-step: a Rust CLI on PolyCore that builds parts from JSON
    recipes (boxes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
    [ankle_left.stl, ankle_right.stl, arm_L.stl, arm_R.stl, jaw.stl, jaw_soft.stl, leg.stl, leg_2.stl]
2026-10-29 Design: TinyREX's own frame brackets, carved from Microduck's envelopes
    Each placeholder bracket box becomes a designed part: pocketed round the
    servo cases, horns, hubs, bearings, battery and cables it holds (a cradle),
    plates lightened with holes, battery holder split into two clamps, edges kept
    at the placeholders' rounds, printed in the boards' dark frame colour. Being
    subsets of the clip-checked envelopes they add no clip; limits unchanged,
    supports and bosses resolved, STEP valid (22 of 23 brackets exact). Renders,
    labelled views, sim meshes and the audit updated.
    [ankle_left.stl, ankle_right.stl, bearing_roll.stl, hip_l.stl, hip_l_2.stl, jaw.stl, jaw_soft.stl, leg.stl]
2026-10-29 Design: frame brackets screwed to their servos' case holes; counts and mass refreshed
    From each held XL330's threaded case holes a ray finds the bracket wall: an
    M2 clearance hole and a screw head go there; any screw that would touch
    something is removed with its hole (34 kept). Limits unchanged, no clips,
    nothing floating, STEP valid (668 solids). Audit counts corrected (303 parts,
    112 screws, 22 bosses); mass 1001.7 g, TinyREX HOME 19.49 deg.
    [ankle_left.stl, ankle_right.stl, bearing_roll.stl, jaw_soft.stl, tinyrex_v4.blend, upper_leg_left.stl, upper_leg_right.stl, yaw2roll.stl]
2026-10-29 Polykrom: TinyREX opens in Polykrom; watertight print kit from the exact solids
    The STEP assembly opens in Polykrom in ~3 s (668 bodies). A print kit splits
    Polykrom's 3MF into one STL per printed part (111), welded, consistently
    wound and capped where tessellation left gaps: all watertight (108 from
    PolyCore's solids, 3 from Blender's closed meshes). Generated files ignored.
2026-10-29 Sim: trained walk with tail balance, get-ups from real falls, interactive viewer
    train.py optimises (CMA-ES) a feedback walk and per-landing get-ups, scored
    against a bank of recorded falls; play.py runs them in the MuJoCo viewer.
    build_mjcf.py adds per-body hull boxes so the shells touch the floor.
2026-10-29 Design: built to tumble - folded details, slip clutches, stiff tail, new sim
    TinyREX gets itself up with its head, tail and arms, so it has to survive
    falls (sim: head and tail hit at 1.7-1.8 m/s, arms take up to 80 N).
    - Glued details print with their parts: head spikes, brows and eye
    sockets, the back spike, tail spikes, toe caps (two-colour prints where
    the colour differs) and every insert boss. 303 -> 266 parts.
    - Slip clutches (TPU friction under a wave-spring screw, ~1.2 N m) on both
    shoulders, the jaw and the tail: above any get-up push, below a fall, so
    the XL330 gears don't strip. The tail stays on, on rigid collars and a
    4 mm carbon spine instead of TPU flex rings.
    - 2.4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
    [ankle_left.stl, ankle_right.stl, arm_L.stl, arm_R.stl, jaw.stl, jaw_soft.stl, tail.stl, tinyrex_v4.blend]
2026-10-29 Sim: runtime for sim and robot, expressive moves, rehearsal tests
    runtime.py runs one 50 Hz loop on the simulator and the real robot, as
    Microduck's sim2real does: robot.py reads only what the robot can sense
    (joints; IMU gravity and rate in the trunk frame) and writes joint targets
    (SimRobot in MuJoCo with optional noise and latency; DynamixelRobot over the
    XL330 TTL bus, clamped to the collision-free limits; imu.py turns the head
    IMU into the trunk frame through the neck joints). Behaviours hot-swap:
    stand, walk, get-up (fall or stuck), and emotes.py: yes, no, excited, roar,
    chomp, curious, sad, wave. `runtime.py rehearse` tests them all with noise
    and latency. train.py: the walk trains un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
    [servos.json]
2026-10-29 Sim: walk trained under runtime conditions; on-back and side rolls retrained
    The walk trains at 50 Hz with a tick of latency, noisy IMU, randomised grip
    and trunk mass: runtime.py rehearse now passes 15/15 (1.56 m in 10 s with
    noise and latency, was 0.46 m). On its back it rolls onto its belly, then
    the face-down get-up (7/18 recorded falls, was 1/18); left side 27/41.
2026-10-29 Make runtime.py rehearse exit 1 when a test fails; pin the sim's Python deps
    rehearse printed FAIL lines but always exited 0, so a gate running it could never fail.
    requirements.txt pins the versions the trained controllers were checked with.
    [runtime.py]
2026-10-29 Install the eng kit (ADAMANT) with TinyREX's checks
    Fast: Python compile and JSON parse of sim data and limits. Full: also the polycore-step cargo
    tests and runtime.py rehearse via uv. AGENTS.md records the repo map and its invariants
    (Microduck licensing, measured joint limits, regenerate the sim after geometry changes).
